ianm8/HySSB/HySSB_Block_Diagram.pdf

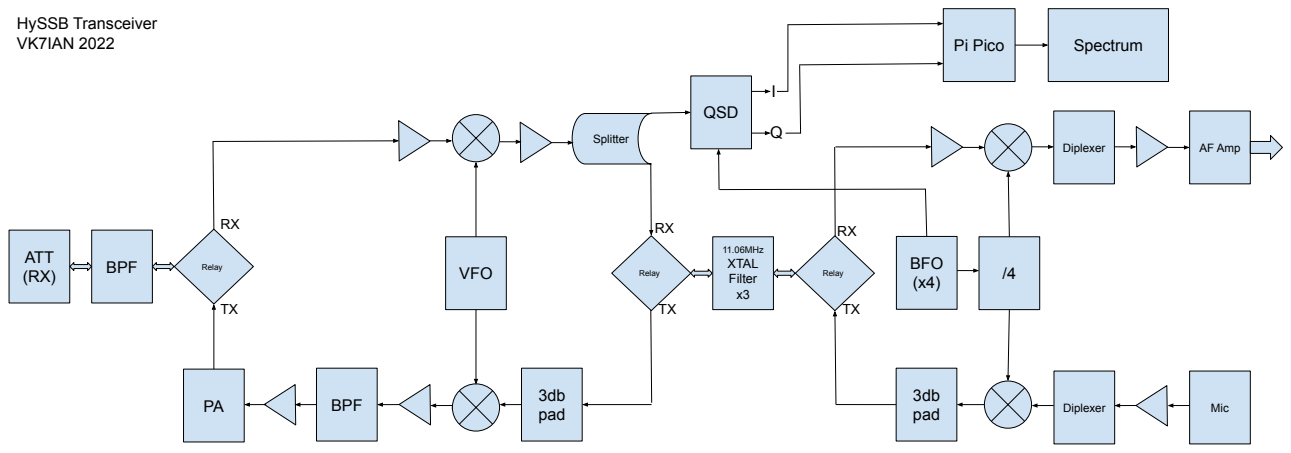
[picture p8: page 1]
ATT; BPF; Relay; Splitter; QSD; VFO; pad PA; 11.06MHz XTAL Filter x3; BFO; pad; Diplexer; AF Amp; Mic; Pi Pico; Spectrum; HySSB Transceiver VK7IAN 2022
