ianm8/HySSB/src/Spectrum.cpp

/* fix_fft.c - Fixed-point in-place Fast Fourier Transform  */
/*
  All data are fixed-point int16_t integers, in which -32768
  to +32768 represent -1.0 to +1.0 respectively. Integer
  arithmetic is used for speed, instead of the more natural
  floating-point.

  For the forward FFT (time -> freq), fixed scaling is
  performed to prevent arithmetic overflow, and to map a 0dB
  sine/cosine wave (i.e. amplitude = 32767) to two -6dB freq
  coefficients. The return value is always 0.

  For the inverse FFT (freq -> time), fixed scaling cannot be
  done, as two 0dB coefficients would sum to a peak amplitude
  of 64K, overflowing the 32k range of the fixed-point integers.
  Thus, the fix_fft() routine performs variable scaling, and
  returns a value which is the number of bits LEFT by which
  the output must be shifted to get the actual amplitude
  (i.e. if fix_fft() returns 3, each value of fr[] and fi[]
  must be multiplied by 8 (2**3) for proper scaling.
  Clearly, this cannot be done within fixed-point int16_t
  integers. In practice, if the result is to be used as a
  filter, the scale_shift can usually be ignored, as the
  result will be approximately correctly normalized as is.

  Written by:  Tom Roberts  11/8/89
  Made portable:  Malcolm Slaney 12/15/94 malcolm@interval.com
  Enhanced:  Dimitrios P. Bouras  14 Jun 2006 dbouras@ieee.org
*/
#include "Radio.h"
#include "Spectrum.h"
#include "hardware/adc.h"

#define _max(a,b) ((a)>(b)?(a):(b))
#define _min(a,b) ((a)<(b)?(a):(b))

/*
  Henceforth "int16_t" implies 16-bit word. If this is not
  the case in your architecture, please replace "int16_t"
  with a type definition which *is* a 16-bit word.
*/

/*
  Since we only use 3/4 of N_WAVE, we define only
  this many samples, in order to conserve data space.
*/
static const int16_t Sinewave[N_WAVE-N_WAVE/4] =
{
      0,    201,    402,    603,    804,   1005,   1206,   1406,
   1607,   1808,   2009,   2209,   2410,   2610,   2811,   3011,
   3211,   3411,   3611,   3811,   4011,   4210,   4409,   4608,
   4807,   5006,   5205,   5403,   5601,   5799,   5997,   6195,
   6392,   6589,   6786,   6982,   7179,   7375,   7571,   7766,
   7961,   8156,   8351,   8545,   8739,   8932,   9126,   9319,
   9511,   9703,   9895,  10087,  10278,  10469,  10659,  10849,
  11038,  11227,  11416,  11604,  11792,  11980,  12166,  12353,
  12539,  12724,  12909,  13094,  13278,  13462,  13645,  13827,
  14009,  14191,  14372,  14552,  14732,  14911,  15090,  15268,
  15446,  15623,  15799,  15975,  16150,  16325,  16499,  16672,
  16845,  17017,  17189,  17360,  17530,  17699,  17868,  18036,
  18204,  18371,  18537,  18702,  18867,  19031,  19194,  19357,
  19519,  19680,  19840,  20000,  20159,  20317,  20474,  20631,
  20787,  20942,  21096,  21249,  21402,  21554,  21705,  21855,
  22004,  22153,  22301,  22448,  22594,  22739,  22883,  23027,
  23169,  23311,  23452,  23592,  23731,  23869,  24006,  24143,
  24278,  24413,  24546,  24679,  24811,  24942,  25072,  25201,
  25329,  25456,  25582,  25707,  25831,  25954,  26077,  26198,
  26318,  26437,  26556,  26673,  26789,  26905,  27019,  27132,
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
  27263, 27338, 27413, 27487, 27561, 27634, 27707, 27780, 27852, 27923, 27995,
  28065, 28136, 28206, 28275, 28344, 28412, 28481, 28548, 28615, 28682, 28748,
  28814, 28879, 28944, 29009, 29073, 29136, 29199, 29261, 29323, 29385, 29446,
  29506, 29566, 29626, 29685, 29743, 29801, 29859, 29916, 29972, 30028, 30083,
  30138, 30193, 30247, 30300, 30353, 30405, 30457, 30508, 30559, 30609, 30659,
  30708, 30756, 30804, 30852, 30899, 30945, 30991, 31036, 31081, 31125, 31169,
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
};

/*
  FIX_MPY() - fixed-point multiplication & scaling.
  Substitute inline assembly for hardware-specific
  optimization suited to a particluar DSP processor.
  Scaling ensures that result remains 16-bit.
*/
inline int16_t FIX_MPY(int16_t a, int16_t b)
{
	/* shift right one less bit (i.e. 15-1) */
	int32_t c = ((int32_t)a * (int32_t)b) >> 14;
	/* last bit shifted out = rounding-bit */
	b = c & 0x01;
	/* last shift + rounding bit */
	a = (c >> 1) + b;
	return a;
}

/*
  fix_fft() - perform forward/inverse fast Fourier transform.
  fr[n],fi[n] are real and imaginary arrays, both INPUT AND
  RESULT (in-place FFT), with 0 <= n < 2**m; set inverse to
  0 for forward transform (FFT), or 1 for iFFT.
*/
int32_t fix_fft(int16_t fr[], int16_t fi[], int16_t m, const int16_t inverse=0)
{
	int32_t mr, nn, i, j, l, k, istep, n, scale, shift;
	int16_t qr, qi, tr, ti, wr, wi;

	n = 1 << m;

	/* max FFT size = N_WAVE */
	if (n > N_WAVE)
		return -1;

	mr = 0;
	nn = n - 1;
	scale = 0;

	/* decimation in time - re-order data */
	for (m=1; m<=nn; ++m)
	{
		l = n;
		do
		{
			l >>= 1;
		} while (mr+l > nn);
		mr = (mr & (l-1)) + l;

		if (mr <= m)
			continue;
		tr = fr[m];
		fr[m] = fr[mr];
		fr[mr] = tr;
		ti = fi[m];
		fi[m] = fi[mr];
		fi[mr] = ti;
	}

	l = 1;
	k = LOG2_N_WAVE-1;
	while (l < n)
	{
		if (inverse)
		{
			/* variable scaling, depending upon data */
			shift = 0;
			for (i=0; i<n; ++i)
			{
				j = fr[i];
				if (j < 0)
					j = -j;
				m = fi[i];
				if (m < 0)
					m = -m;
				if (j > 16383 || m > 16383)
				{
					shift = 1;
					break;
				}
			}
			if (shift) ++scale;
		}
		else
		{
			/*
			  fixed scaling, for proper normalization --
			  there will be log2(n) passes, so this results
			  in an overall factor of 1/n, distributed to
			  maximize arithmetic accuracy.
			*/
			shift = 1;
		}
		/*
		  it may not be obvious, but the shift will be
		  performed on each data point exactly once,
		  during this pass.
		*/
		istep = l << 1;
		for (m=0; m<l; ++m)
		{
			j = m << k;
			/* 0 <= j < N_WAVE/2 */
			wr =  Sinewave[j+N_WAVE/4];
			wi = -Sinewave[j];
			if (inverse)
				wi = -wi;
			if (shift)
			{
				wr >>= 1;
				wi >>= 1;
			}
			for (i=m; i<n; i+=istep)
			{
				j = i + l;
				tr = FIX_MPY(wr,fr[j]) - FIX_MPY(wi,fi[j]);
				ti = FIX_MPY(wr,fi[j]) + FIX_MPY(wi,fr[j]);
				qr = fr[i];
				qi = fi[i];
				if (shift)
				{
					qr >>= 1;
					qi >>= 1;
				}
				fr[j] = qr - tr;
				fi[j] = qi - ti;
				fr[i] = qr + tr;
				fi[i] = qi + ti;
			}
		}
		--k;
		l = istep;
	}
	return scale;
}

/*
  fix_fftr() - forward/inverse FFT on array of real numbers.
  Real FFT/iFFT using half-size complex FFT by distributing
  even/odd samples into real/imaginary arrays respectively.
  In order to save data space (i.e. to avoid two arrays, one
  for real, one for imaginary samples), we proceed in the
  following two steps: a) samples are rearranged in the real
  array so that all even samples are in places 0-(N/2-1) and
  all imaginary samples in places (N/2)-(N-1), and b) fix_fft
  is called with fr and fi pointing to index 0 and index N/2
  respectively in the original array. The above guarantees
  that fix_fft "sees" consecutive real samples as alternating
  real and imaginary samples in the complex array.
*/
int32_t fix_fftr(int16_t f[], int32_t m, int32_t inverse)
{
	int32_t i, N = 1<<(m-1), scale = 0;
	int16_t tt, *fr=f, *fi=&f[N];

	if (inverse)
		scale = fix_fft(fi, fr, m-1, inverse);
	for (i=1; i<N; i+=2) {
		tt = f[N+i-1];
		f[N+i-1] = f[i];
		f[i] = tt;
	}
	if (! inverse)
		scale = fix_fft(fi, fr, m-1, inverse);
	return scale;
}

Spectrum::Spectrum(void)
{
  for (int32_t i=0;i<N_WAVE;i++)
  {
    mag[i]= 0;
  }
  AGC = 0;
  _new_refcount = 0;
  _old_refcount = 0;
  
}

void Spectrum::FFT(int16_t fr[], int16_t fi[], int16_t m)
{
  const int32_t n = 1 << m;

  /* max FFT size = N_WAVE */
  if (n > N_WAVE) return;

  int32_t mr = 0;
  int32_t nn = n - 1;

  /* decimation in time - re-order data */
  for (m=1; m<=nn; ++m)
  {
    int32_t l = n;
    do
    {
      l >>= 1;
    } while (mr+l > nn);
    mr = (mr & (l-1)) + l;

    if (mr <= m)
      continue;

    const int16_t tr = fr[m];
    fr[m] = fr[mr];
    fr[mr] = tr;
    const int16_t ti = fi[m];
    fi[m] = fi[mr];
    fi[mr] = ti;
  }

  int32_t l = 1;
  int32_t k = LOG2_N_WAVE-1;
  while (l < n)
  {
    const int32_t istep = l << 1;
    for (m=0; m<l; ++m)
    {
      const int32_t j = m << k;
      /* 0 <= j < N_WAVE/2 */
      int16_t wr =  Sinewave[j+N_WAVE/4];
      int16_t wi = -Sinewave[j];
      wr >>= 1;
      wi >>= 1;
      for (int32_t i=m; i<n; i+=istep)
      {
        const int32_t j = i + l;
        const int16_t tr = FIX_MPY(wr,fr[j]) - FIX_MPY(wi,fi[j]);
        const int16_t ti = FIX_MPY(wr,fi[j]) + FIX_MPY(wi,fr[j]);
        const int16_t qr = fr[i]>>1;
        const int16_t qi = fi[i]>>1;
        fr[j] = qr - tr;
        fi[j] = qi - ti;
        fr[i] = qr + tr;
        fi[i] = qi + ti;
      }
    }
    k--;
    l = istep;
  }
}

static const uint8_t log16(const uint32_t l)
{
  // return a 4 bit log value
  if (l>4095) return 0x0fu;
  static const uint8_t logtab16[4096] = 
  {
    0x00u,
    0x00u,
    0x01u,
    0x02u,
    0x02u,
    0x02u,
    0x03u,
    0x03u,
    0x03u,
    0x04u,
    0x04u,
    0x04u,
    0x04u,
    0x04u,
    0x04u,
    0x05u,
    0x05u,
    0x05u,
    0x05u,
    0x05u,
    0x05u,
    0x05u,
    0x05u,
    0x05u,
    0x05u,
    0x05u,
    0x06u,
    0x06u,
    0x06u,
    0x06u,
    0x06u,
    0x06u,
    0x06u,
    0x06u,
    0x06u,
    0x06u,
    0x06u,
    0x06u,
    0x06u,
    0x06u,
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
  };
  return logtab16[l];
}

static const uint8_t log32(const uint32_t l)
{
  // return a 5 bit log value
  if (l>4095) return 0x1fu;
  static const uint8_t logtab32[4096] = 
  {
    0x00u,
    0x00u,
    0x02u,
    0x04u,
    0x05u,
    0x06u,
    0x06u,
    0x07u,
    0x07u,
    0x08u,
    0x08u,
    0x09u,
    0x09u,
    0x09u,
    0x09u,
    0x0Au,
    0x0Au,
    0x0Au,
    0x0Au,
    0x0Bu,
    0x0Bu,
    0x0Bu,
    0x0Bu,
    0x0Bu,
    0x0Cu,
    0x0Cu,
    0x0Cu,
    0x0Cu,
    0x0Cu,
    0x0Cu,
    0x0Cu,
    0x0Cu,
    0x0Du,
    0x0Du,
    0x0Du,
    0x0Du,
    0x0Du,
    0x0Du,
    0x0Du,
    0x0Du,
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
  };
  return logtab32[l];
}

void Spectrum::process(uint32_t speed)
{
  // (2049 values 0-2048)
  static const uint16_t NRAW = N_WAVE*2+1;
  int16_t adc_i[NRAW];
  int16_t adc_q[NRAW];
  int16_t re[N_WAVE];
  int16_t im[N_WAVE];
  int32_t magnitude[N_WAVE];

  speed = constrain(speed,1,8);
  analogReadResolution(12);
  // get the voltage on the AGC line
  // it is convenient to do it here
  // assuming the AGC voltage is about 0.65 for S9 signal
  // the adc will return a value of about 800
  // ie (0.65 / (3.3/4096)) or 4096 * 0.65 / 3.3
  // 800 / 64 = 12
  uint32_t agc = 0;
  for (uint32_t i=0;i<8;i++) agc += analogRead(Radio::PIN_AGC);
  AGC = agc >> 9; // / 64 / 8

  // collect NRAW (2049, 0-2048) values @ 250KHz per channel (interleaved)
  // later we will decimate to 1024 values (and 125KHz)
/*
  for (uint32_t i=0;i<NRAW;i++)
  {
    adc_i[i] = analogRead(Radio::PIN_QSDI);
    adc_q[i] = analogRead(Radio::PIN_QSDQ);
  }
*/

///*
  adc_init();
  adc_gpio_init(Radio::PIN_QSDI);
  adc_gpio_init(Radio::PIN_QSDQ);
  memset(magnitude,0,sizeof(magnitude));
  for (uint32_t j=0;j<speed;j++)
  {
    for (uint32_t i=0;i<NRAW;i++)
    {
      adc_select_input(Radio::ADC_QSDI);
      adc_i[i] = adc_read();
      //asm volatile ("nop");
      adc_select_input(Radio::ADC_QSDQ);
      adc_q[i] = adc_read();
    }
//*/
/*
    adc_init();
    adc_gpio_init(Radio::PIN_QSDI);
    adc_gpio_init(Radio::PIN_QSDQ);
    for (uint32_t i=0;i<2048;i+=8)
    {
      adc_select_input(Radio::ADC_QSDI);adc_i[i+0] = adc_read();
      adc_select_input(Radio::ADC_QSDQ);adc_q[i+0] = adc_read();
      adc_select_input(Radio::ADC_QSDI);adc_i[i+1] = adc_read();
      adc_select_input(Radio::ADC_QSDQ);adc_q[i+1] = adc_read();
      adc_select_input(Radio::ADC_QSDI);adc_i[i+2] = adc_read();
      adc_select_input(Radio::ADC_QSDQ);adc_q[i+2] = adc_read();
      adc_select_input(Radio::ADC_QSDI);adc_i[i+3] = adc_read();
      adc_select_input(Radio::ADC_QSDQ);adc_q[i+3] = adc_read();
      adc_select_input(Radio::ADC_QSDI);adc_i[i+4] = adc_read();
      adc_select_input(Radio::ADC_QSDQ);adc_q[i+4] = adc_read();
      adc_select_input(Radio::ADC_QSDI);adc_i[i+5] = adc_read();
      adc_select_input(Radio::ADC_QSDQ);adc_q[i+5] = adc_read();
      adc_select_input(Radio::ADC_QSDI);adc_i[i+6] = adc_read();
      adc_select_input(Radio::ADC_QSDQ);adc_q[i+6] = adc_read();
      adc_select_input(Radio::ADC_QSDI);adc_i[i+7] = adc_read();
      adc_select_input(Radio::ADC_QSDQ);adc_q[i+7] = adc_read();
    }
    adc_select_input(Radio::ADC_QSDI);adc_i[2048] = adc_read();
    adc_select_input(Radio::ADC_QSDQ);adc_q[2048] = adc_read();
*/  
/*
    for (uint32_t i=0;i<2048;i+=8)
    {
      adc_i[i+0] = analogRead(Radio::PIN_QSDI);
      adc_q[i+0] = analogRead(Radio::PIN_QSDQ);
      adc_i[i+1] = analogRead(Radio::PIN_QSDI);
      adc_q[i+1] = analogRead(Radio::PIN_QSDQ);
      adc_i[i+2] = analogRead(Radio::PIN_QSDI);
      adc_q[i+2] = analogRead(Radio::PIN_QSDQ);
      adc_i[i+3] = analogRead(Radio::PIN_QSDI);
      adc_q[i+3] = analogRead(Radio::PIN_QSDQ);
      adc_i[i+4] = analogRead(Radio::PIN_QSDI);
      adc_q[i+4] = analogRead(Radio::PIN_QSDQ);
      adc_i[i+5] = analogRead(Radio::PIN_QSDI);
      adc_q[i+5] = analogRead(Radio::PIN_QSDQ);
      adc_i[i+6] = analogRead(Radio::PIN_QSDI);
      adc_q[i+6] = analogRead(Radio::PIN_QSDQ);
      adc_i[i+7] = analogRead(Radio::PIN_QSDI);
      adc_q[i+7] = analogRead(Radio::PIN_QSDQ);
    }
    adc_i[2048] = analogRead(Radio::PIN_QSDI);
    adc_q[2048] = analogRead(Radio::PIN_QSDQ);
*/
  
    // compensate for interleaving and convert to signed values
    // (there are 0 to 2047 values to process)
    // 13 bits
    for (uint32_t i=0;i<NRAW-1;i++)
    {
      adc_i[i] = adc_i[i]-2048+adc_i[i+1]-2048;
      adc_q[i] = (adc_q[i]-2048)*2;
    }
  
    // decimate to 1024 values (125KHz per channel)
    // just take the average of two samples
    // no scaling needed since there are plenty of bits
    // 14 bits
    for (uint32_t i=0;i<N_WAVE;i++)
    {
      re[i] = adc_i[i*2]+adc_i[i*2+1];
      im[i] = adc_q[i*2]+adc_q[i*2+1];
    }
  
    // DC removal
    // (get the average and subtract from all samples)
    int32_t dc1 = 0;
    int32_t dc2 = 0;
    for (int32_t i=0;i<N_WAVE;i++)
    {
      dc1 += re[i];
      dc2 += im[i];
    }
    dc1 >>= 10;
    dc2 >>= 10;
    for (uint32_t i=0;i<N_WAVE;i++)
    {
      re[i] -= (int16_t)dc1;
      im[i] -= (int16_t)dc2;
    }
  
    // amplitude correction
    
    
    // phase correction
/*
    if (pc<0)
    {
      for (uint32_t i=0;i<1024;i++)
      {
         im[i] = im[i]+(((int32_t)re[i]*(int32_t)pc)>>15);
      }
    }
    else if (pc>0)
    {
      for (uint32_t i=0;i<1024;i++)
      {
         re[i] = re[i]+(((int32_t)im[i]*(int32_t)pc)>>15);
      }
    }
*/
    
    // Hann window
    for (uint32_t i=0;i<N_WAVE;i++)
    {
      const int32_t w = (int32_t)re[i] * (int32_t)window_hanning_1024[i];
      const int32_t x = (int32_t)im[i] * (int32_t)window_hanning_1024[i];
      re[i] = (int16_t)(w>>15);
      im[i] = (int16_t)(x>>15);
    }
    
    // forward, complex FFT
    FFT(re,im,LOG2_N_WAVE);
  
    // magnitude estimate
    for (uint32_t i=0;i<N_WAVE;i++)
    {
      // magnitude estimate
      const uint16_t m = abs(re[i]);
      const uint16_t n = abs(im[i]);
      uint32_t M = _max(m,n)+(_min(m,n)>>2);
      magnitude[i] += M;
    }
  }

/*    
    // fast log2
    uint8_t l = 0;
    if (M>>8) {M>>=8; l+=8;}
    if (M>>4) {M>>=4; l+=4;}
    if (M>>2) {M>>=2; l+=2;}
    if (M>>1) {M>>=1; l+=1;}
    magnitude[i] = l;
*/
  if (speed==1)
  {
    for (uint32_t i=0;i<N_WAVE;i++)
    {
      magnitude[i] = log32(magnitude[i]);
    }
  }
  else if (speed==2)
  {
    for (uint32_t i=0;i<N_WAVE;i++)
    {
      magnitude[i] = log32(magnitude[i]>>1);
    }
  }
  else if (speed==4)
  {
    for (uint32_t i=0;i<N_WAVE;i++)
    {
      magnitude[i] = log32(magnitude[i]>>2);
    }
  }
  else if (speed==8)
  {
    for (uint32_t i=0;i<N_WAVE;i++)
    {
      magnitude[i] = log32(magnitude[i]>>3);
    }
  }
  else
  {
    for (uint32_t i=0;i<N_WAVE;i++)
    {
      magnitude[i] = log32(magnitude[i]/speed);
    }
  }
  // reverse the frequency bins so that they are in order
  for (int32_t i=0,j=511;i<512;i++,j--)
  {
    mag[i] = magnitude[j];
  }
  for (int32_t i=512,j=1023;i<1024;i++,j--)
  {
    mag[i] = magnitude[j];
  }
}

const boolean Spectrum::isDataReady(void)
{
  // if the old and new refcounts are
  // different, then new data ready
  if (_new_refcount==_old_refcount)
  {
    return false;
  }
  _old_refcount = _new_refcount;
  return true;
}
    
void Spectrum::dataReady(void)
{
  // indicate data is ready by changing the refcount
  _new_refcount++;
}
