ianm8/HySSB/(commit log)

2022-07-31 Update HySSB.ino
    Minor bug fix
    [HySSB.ino]
2022-08-06 WPM and locked fixes
    Show WPM, fixed "locked" message when tuning is locked
    [HySSB.ino]
2022-09-12 Use lower local oscillator signal in transmit mode for 15m and 10m.
    This improves power out on 15m and 10m but switches sideband so need to hack opposite sideband when transmitting.
    [HySSB.ino, si5351A.h, si5351X.cpp]
